Shadowtrance/Huiqin-Zhiyuan-ESP32-S31-CB-V1.1/11. Other materials/Information Website.txt

1、乐鑫官网：

https://www.espressif.com.cn/zh-hans

2、ESP产品选型指南：

https://products.espressif.com/#/product-selector?language=zh&names=

3、ESP-IDF 编程指南：

https://docs.espressif.com/projects/esp-idf/zh_CN/v6.1/esp32s31/index.html

4、VS Code 配置 ESP-IDF 插件：

https://docs.espressif.com/projects/vscode-esp-idf-extension/zh_CN/latest/index.html#

5、ESP-IDF组件下载地址：

https://dl.espressif.cn/dl/esp-idf/

6、VS Code下载地址：

https://code.visualstudio.com/Download
