Shadowtrance/Huiqin-Zhiyuan-ESP32-S31-CB-V1.1/3. Program source code/Source Code Update Log for the ESP32-S31 CB V1.1 Minimal System Board.pdf

东莞市慧勤智远科技有限公司

1

## ESP32-S31 CB V1.1 小系统板源码更新记录

日期 | 更新说明
2026-10-21 | 1、更新基础例程 (1) 增加例程数量。
