Shadowtrance/Huiqin-Zhiyuan-ESP32-S31-CB-V1.1/2. Schematic diagram/ESP32-S31 CB V1.1_SCH.pdf

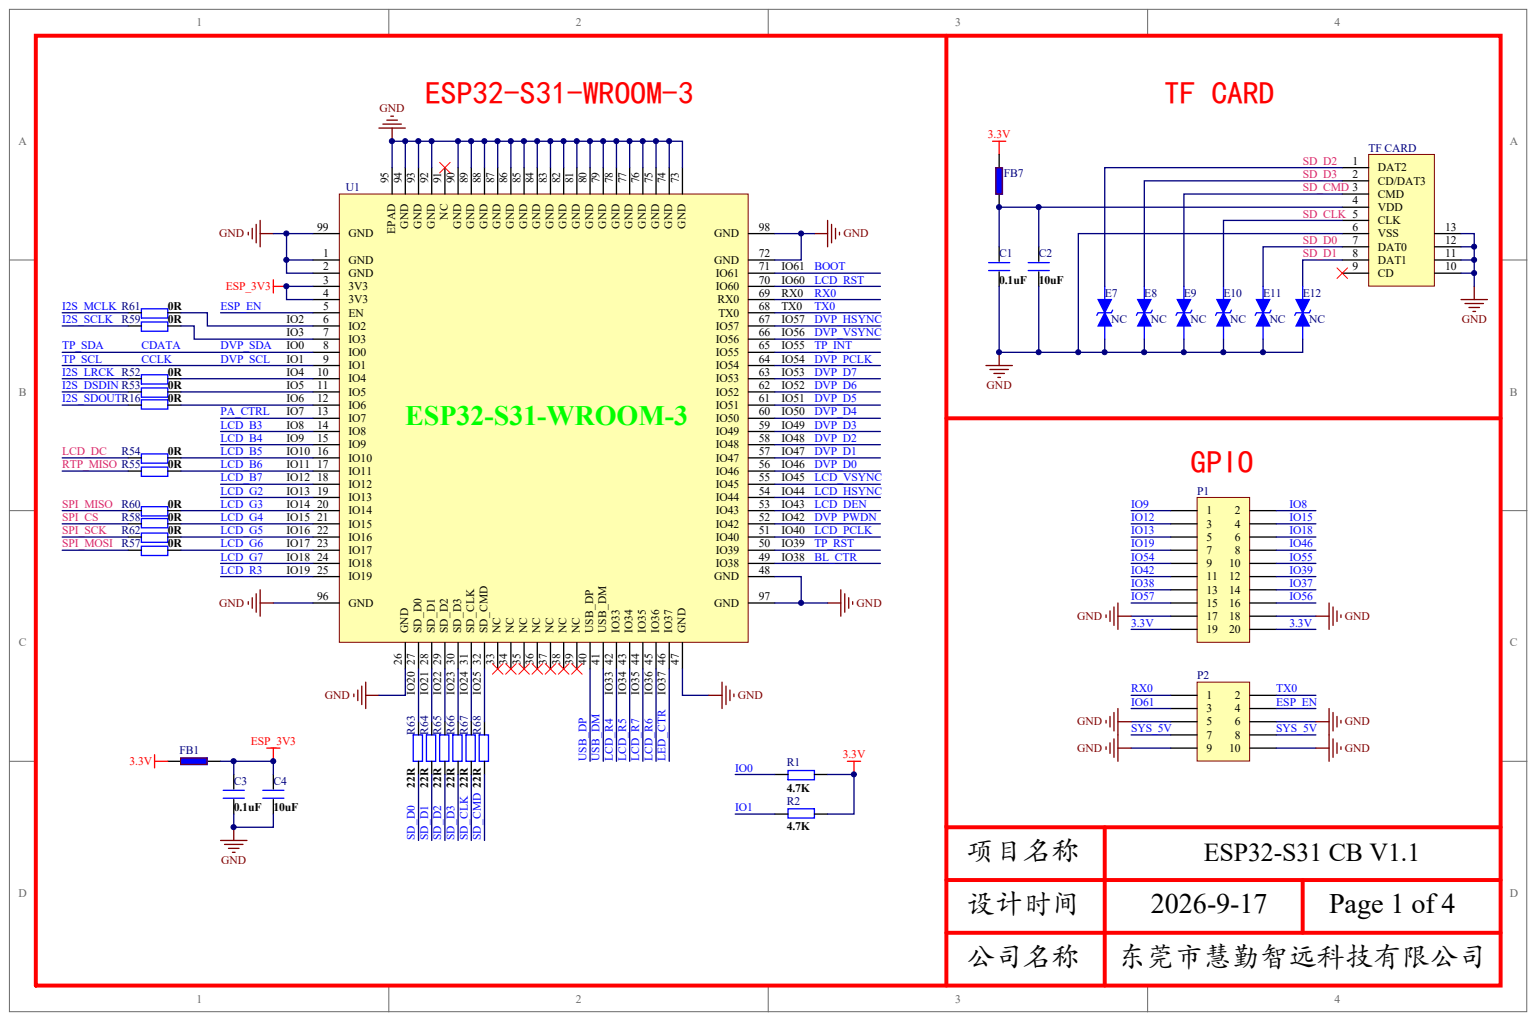
[picture p71: page 1]

GND 74 GND 75 GND 76 GND 77 GND 78 GND 79 GND 80 GND 81 GND 82 GND 83 GND 84 GND 85 GND 86 GND 87 GND 88 GND 89 GND 90 NC 91 GND 92 GND 93 GND 94 EPAD 95

D 3

SD_CLK | 5

项目名称 | ESP32-S31 CB V1.1

设计时间 | 2026-9-17 | Page 1 of 4
公司名称 | 东莞市慧勤智远科技有限公司

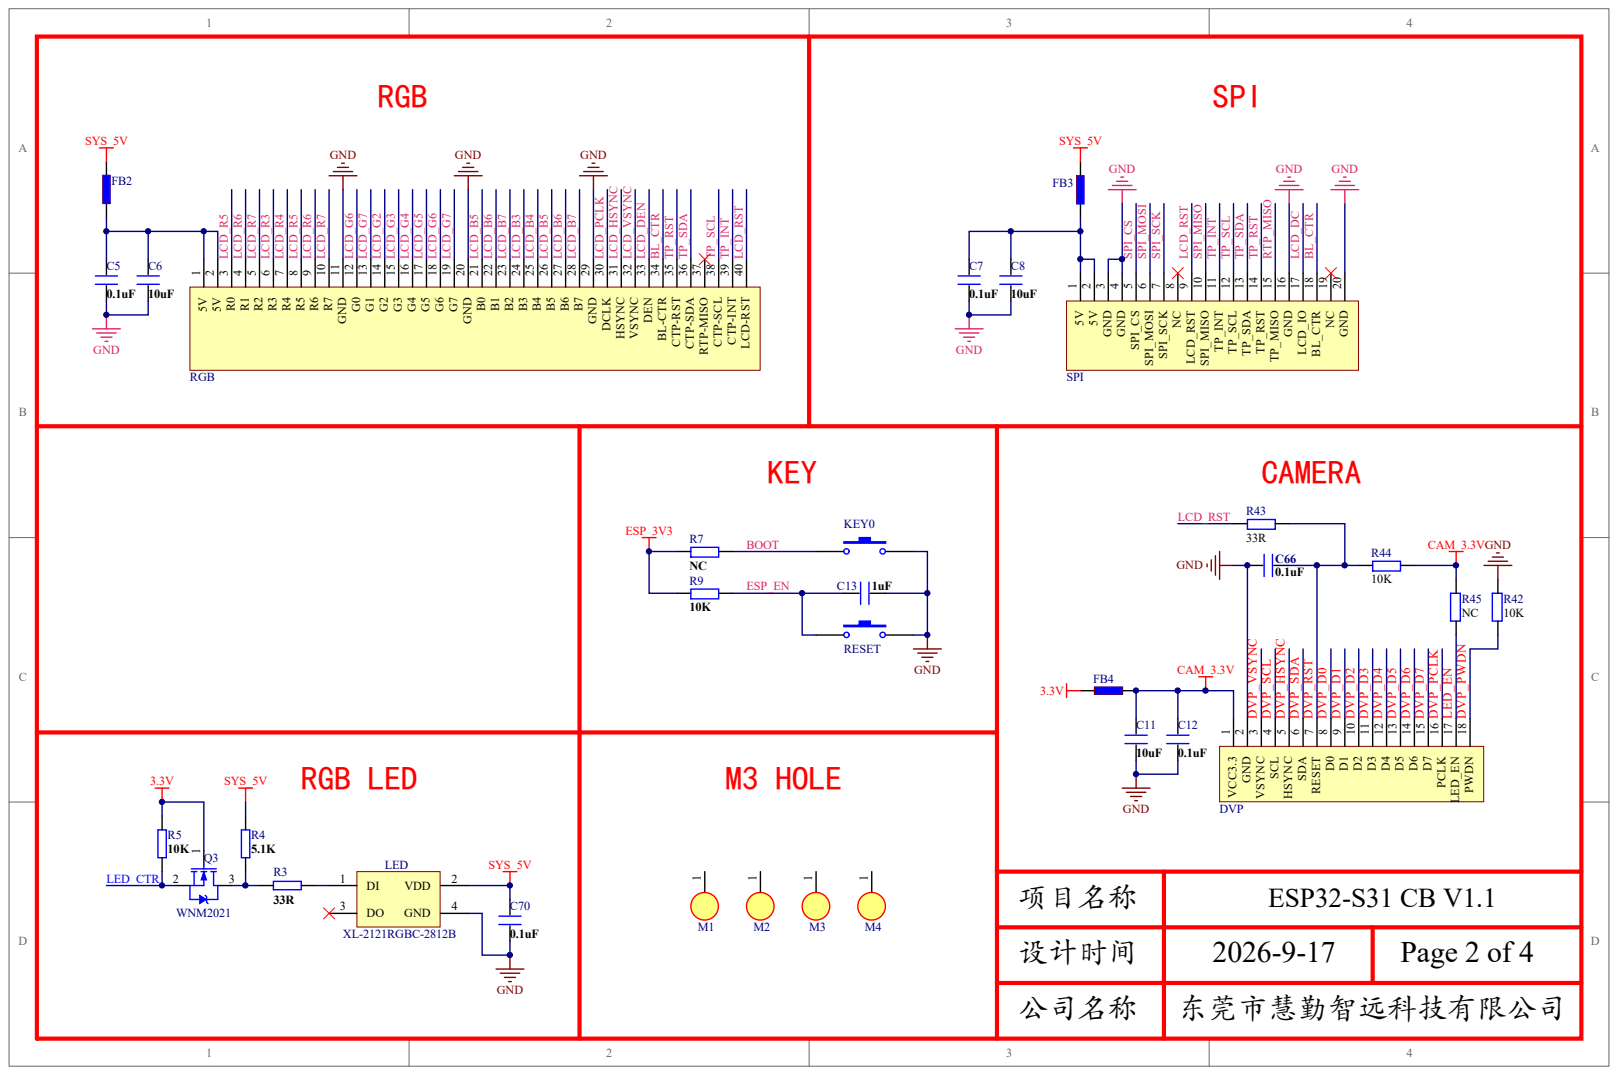
[picture p72: page 2]

设计时间 | 2026-9-17 | Page 2 of 4
公司名称 | 东莞市慧勤智远科技有限公司

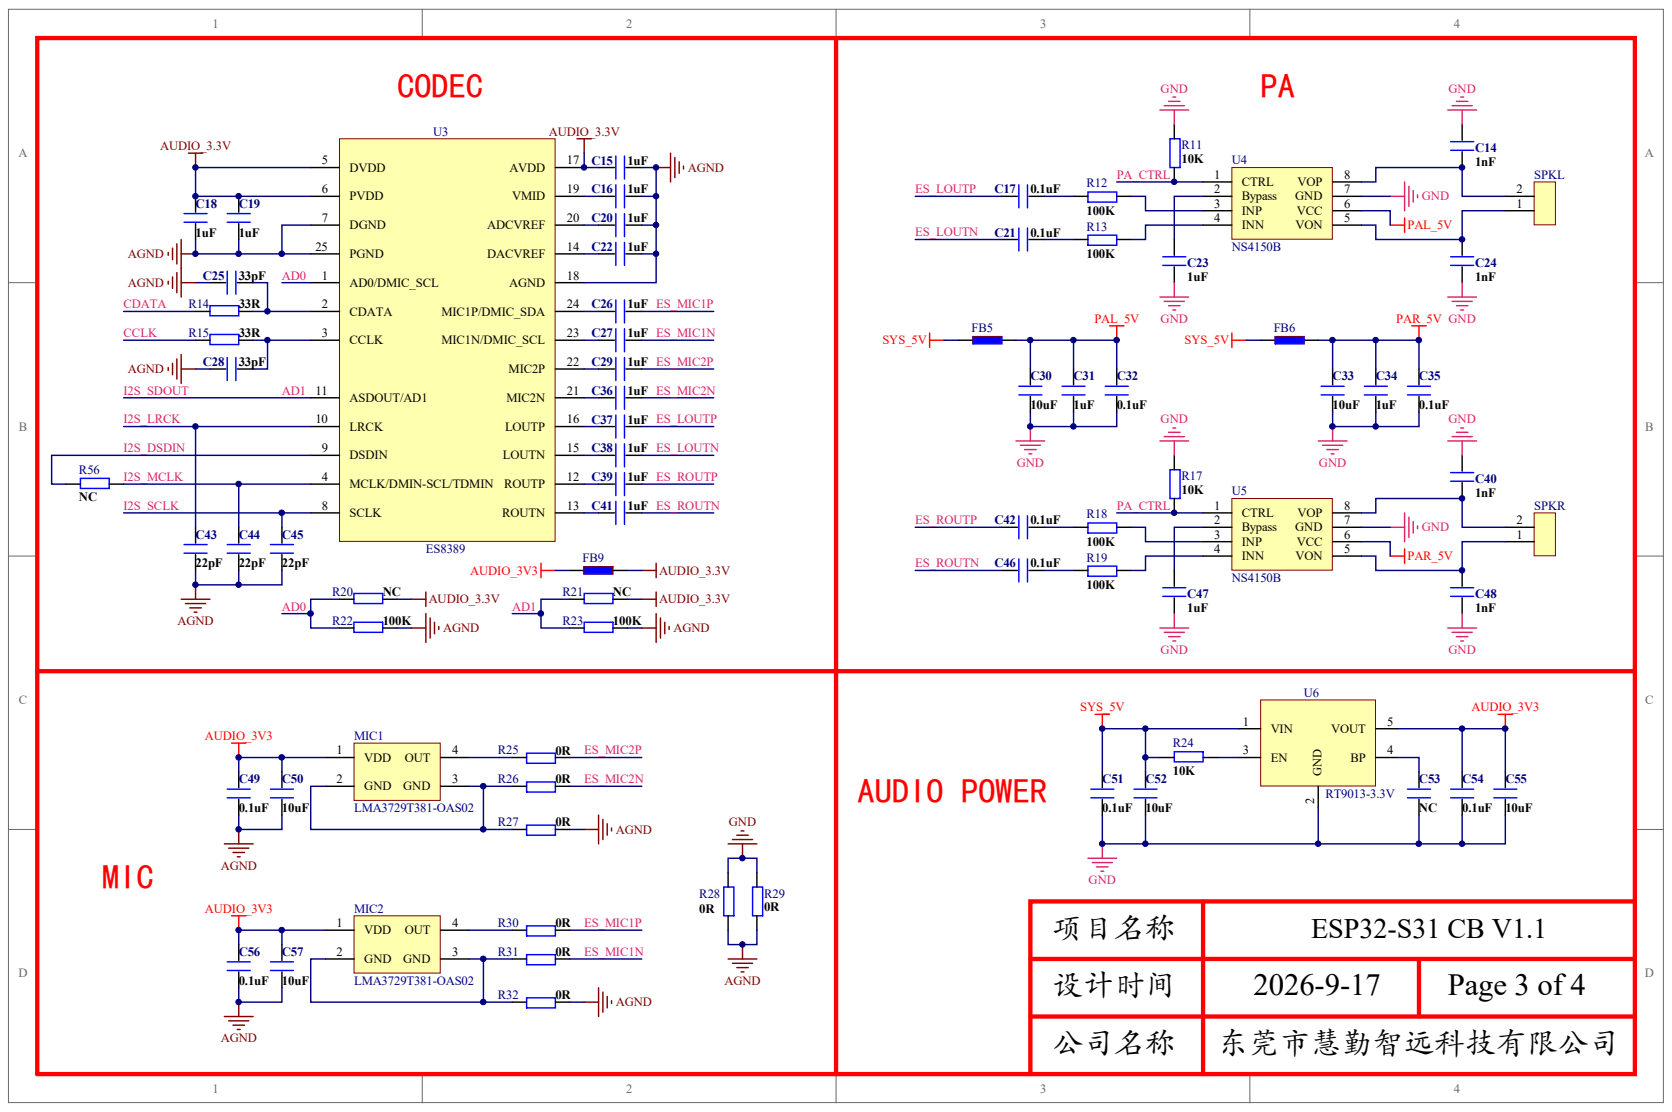
[picture p73: page 3]

R56 | MCLK/DMIN-SCL/TDMIN 4

C43 | SCLK 8

INP 3 | 1

项目名称 | ESP32-S31 CB V1.1

设计时间 | 2026-9-17 | Page 3 of 4
公司名称 | 东莞市慧勤智远科技有限公司

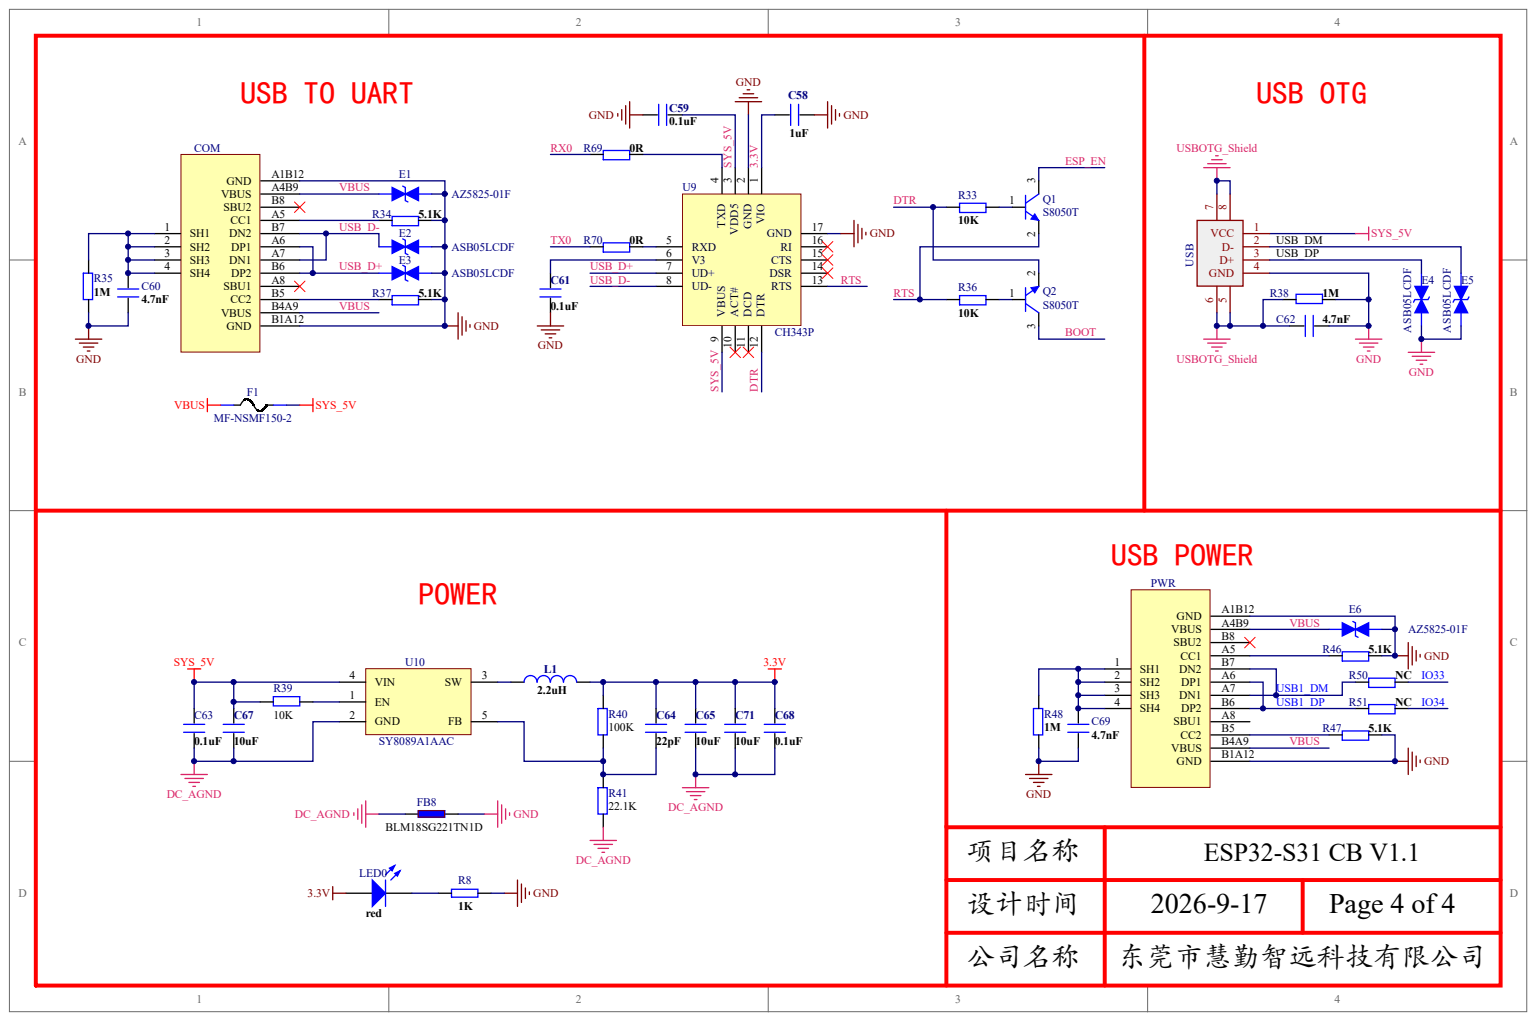
[picture p74: page 4]

项目名称 | ESP32-S31 CB V1.1

设计时间 | 2026-9-17 | Page 4 of 4
公司名称 | 东莞市慧勤智远科技有限公司
