Shadowtrance/Huiqin-Zhiyuan-ESP32-S31-CB-V1.1/10. Camera Module Information/OV2640 Camera Module Product Documentation/1，原理图/WKS-OV2640-V12.pdf

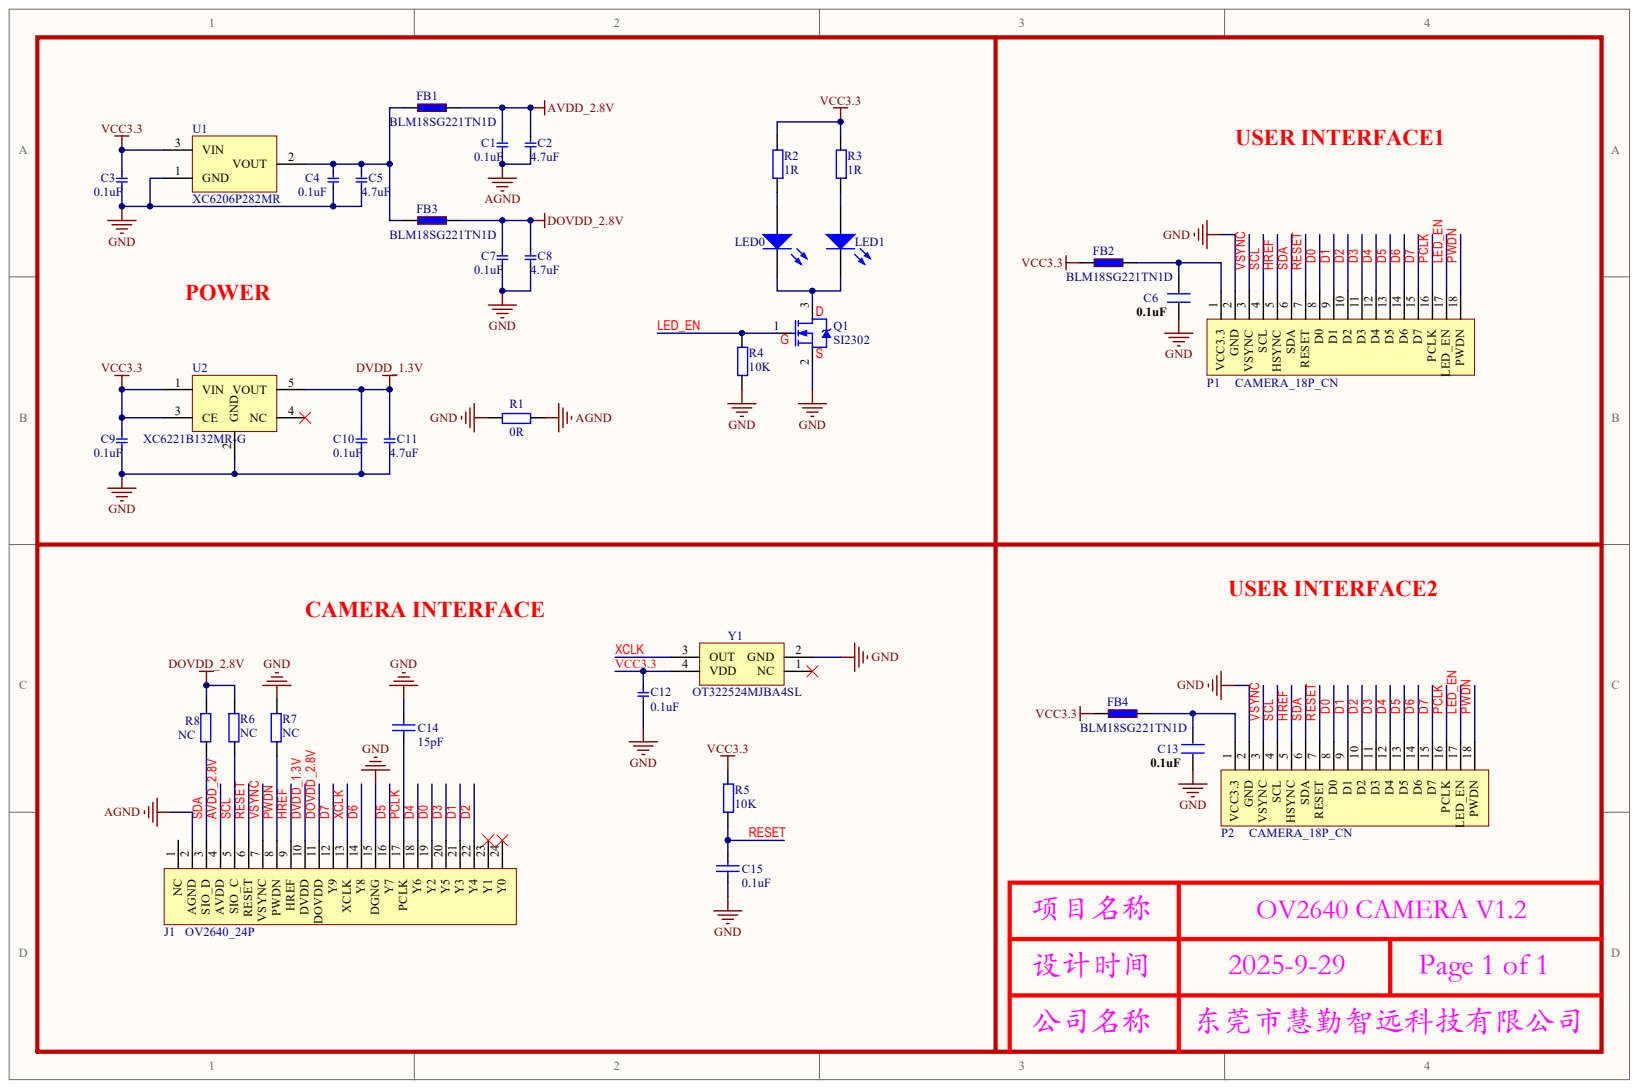
[picture p75: page 1]

项目名称 | OV2640 CAMERA V1.2
设计时间 | 2025-9-29 | Page 1 of 1
公司名称 | 东莞市慧勤智远科技有限公司
