Shadowtrance/Huiqin-Zhiyuan-ESP32-S31-CB-V1.1/2. Schematic diagram/ESP32-S31 CB V1.1 - Front Side Mount Diagram.pdf

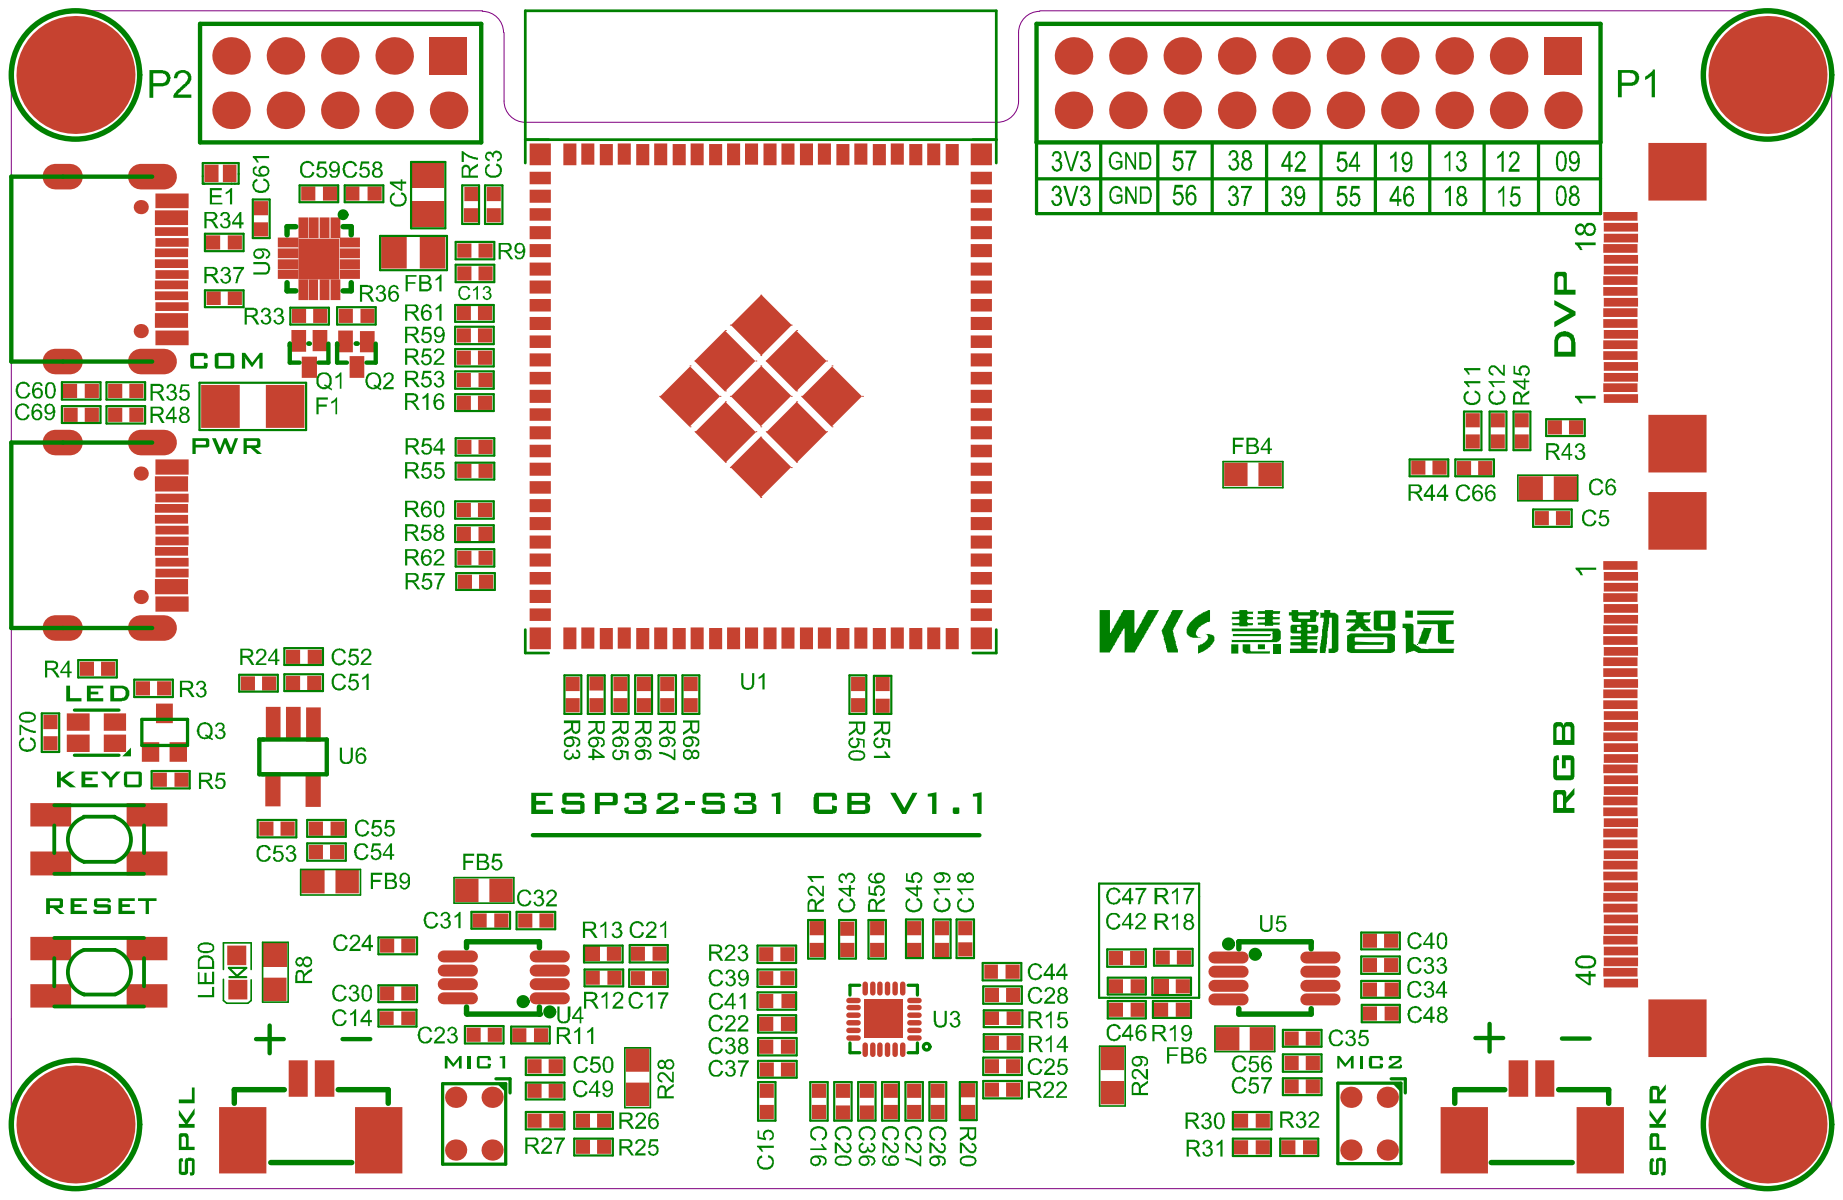
[picture p76: page 1]
