Shadowtrance/Huiqin-Zhiyuan-ESP32-S31-CB-V1.1/2. Schematic diagram/ESP32-S31 CB V1.1 - Rear Part Number Diagram.pdf

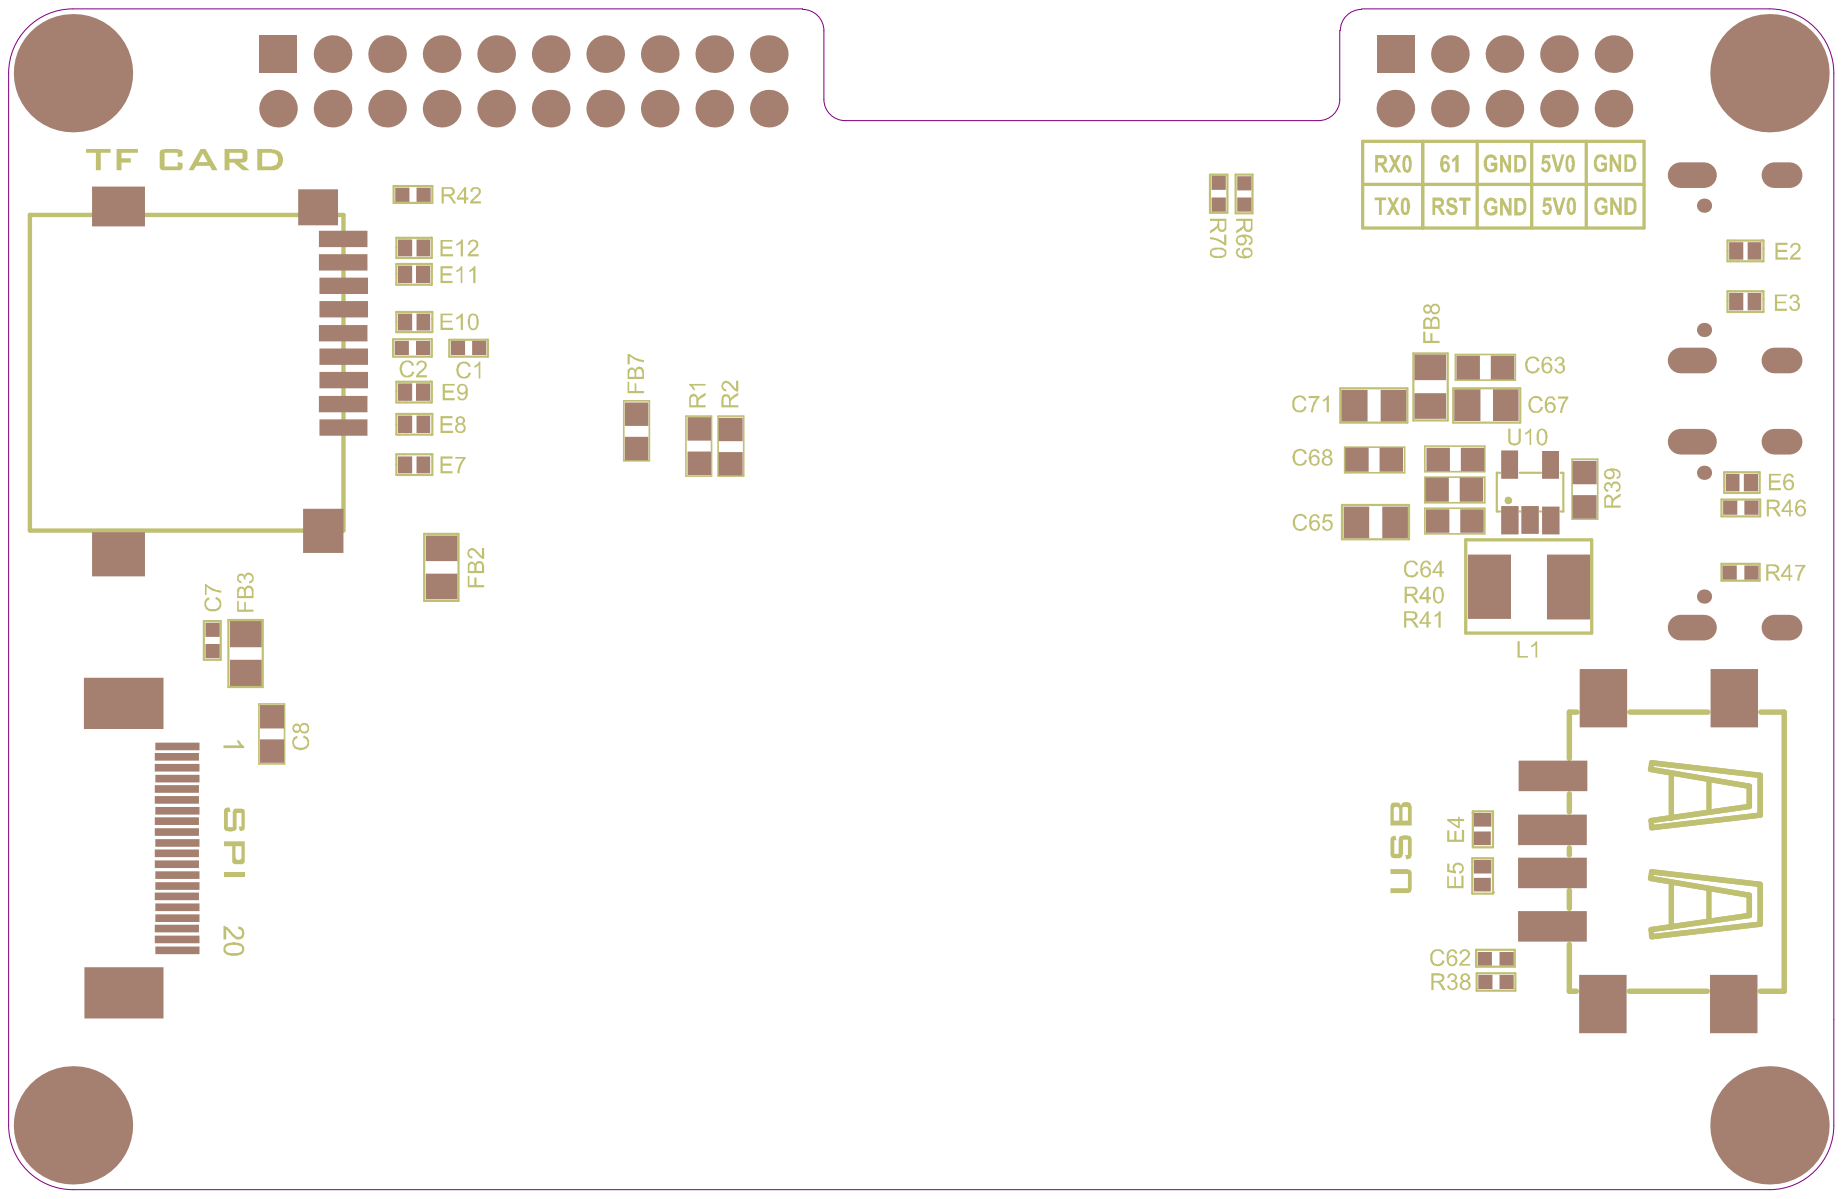
[picture p77: page 1]
