Shadowtrance/Huiqin-Zhiyuan-ESP32-S31-CB-V1.1/6. Development board structure diagram/ESP32-S31 CB V1.1_Structural Diagram.PDF

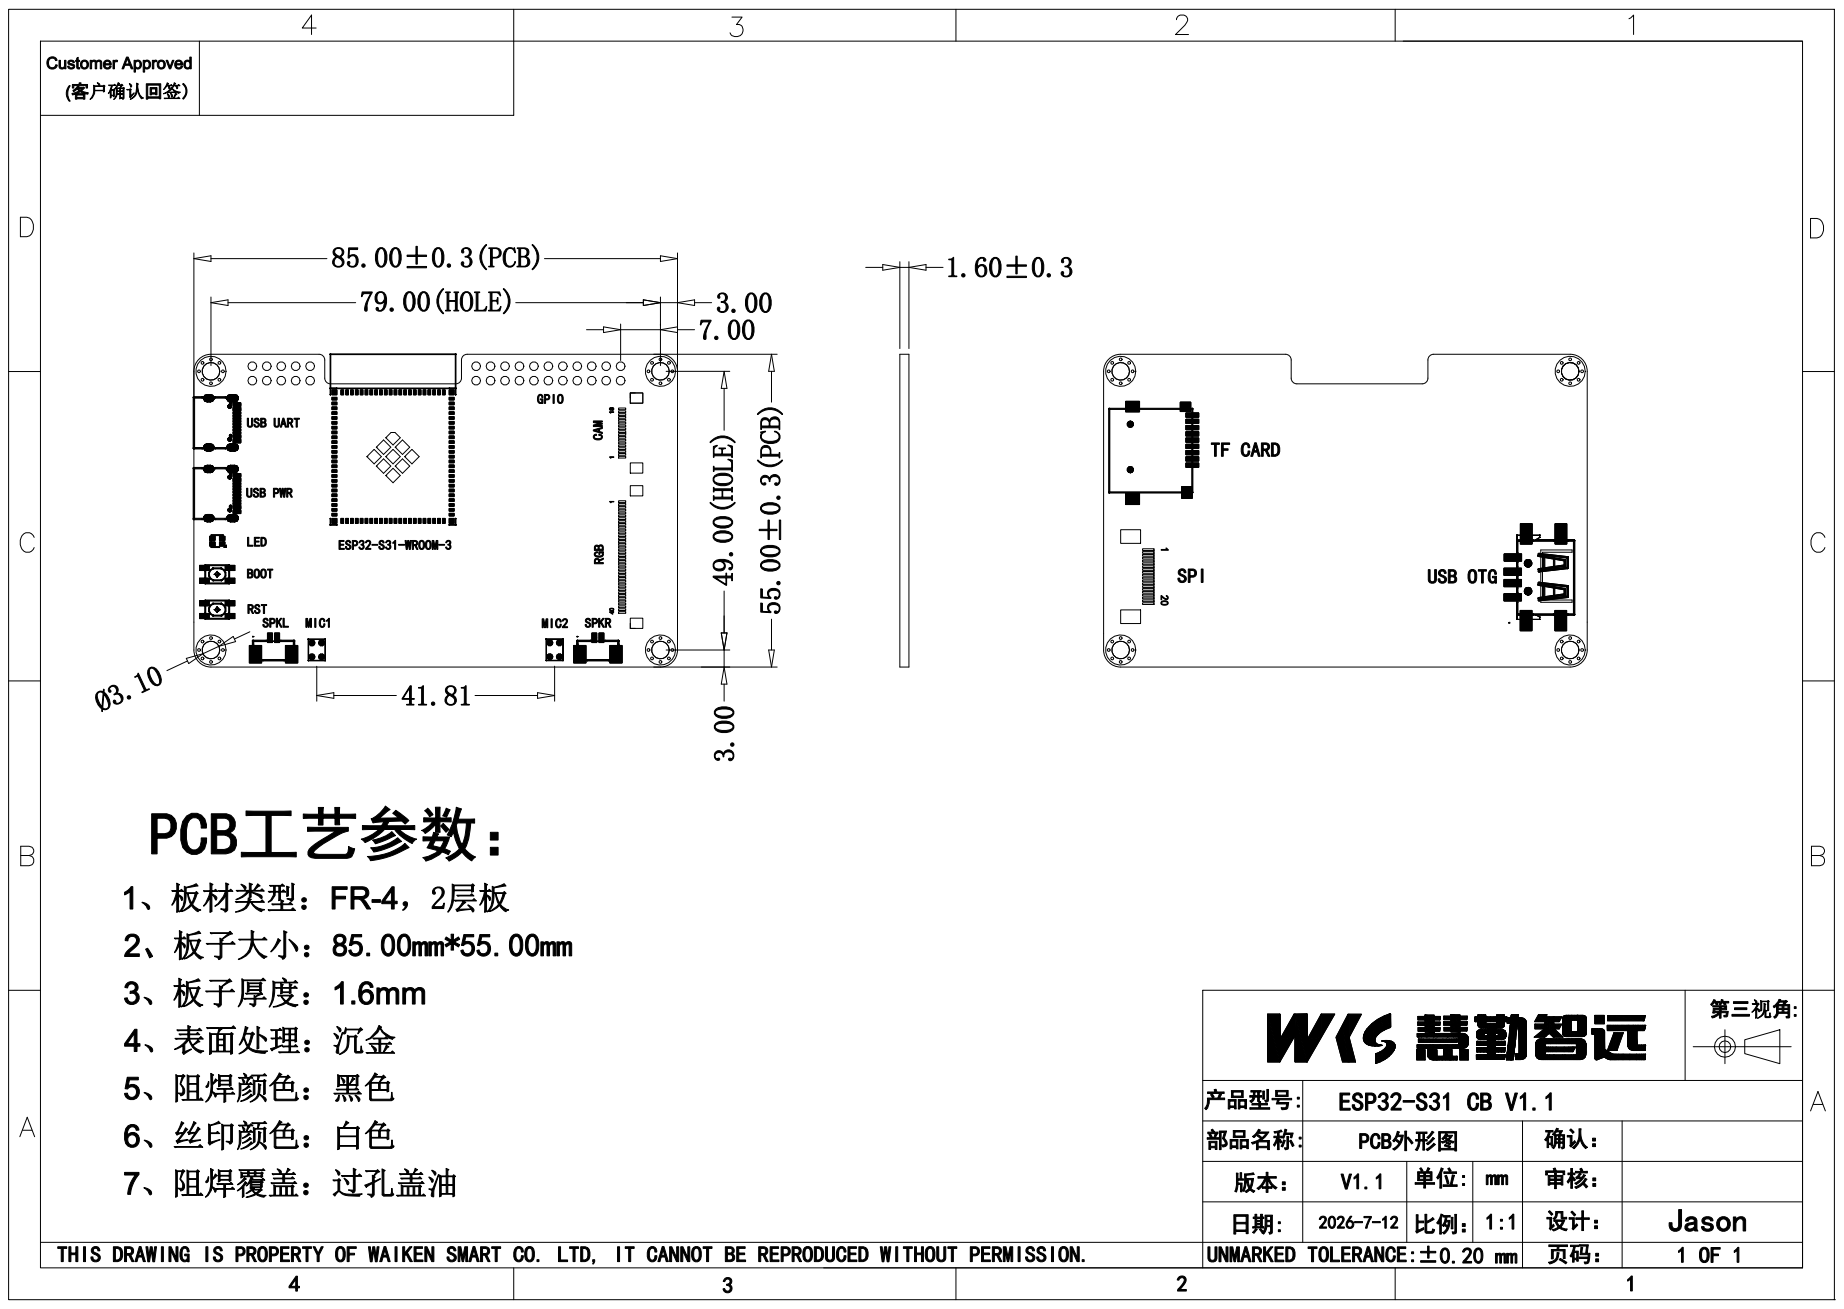
[picture p78: page 1]
