Shadowtrance/Huiqin-Zhiyuan-ESP32-S31-CB-V1.1/10. Camera Module Information/OV2640 Camera Module Product Documentation/2，结构图/WKS-OV2640 V1.2外形图.PDF

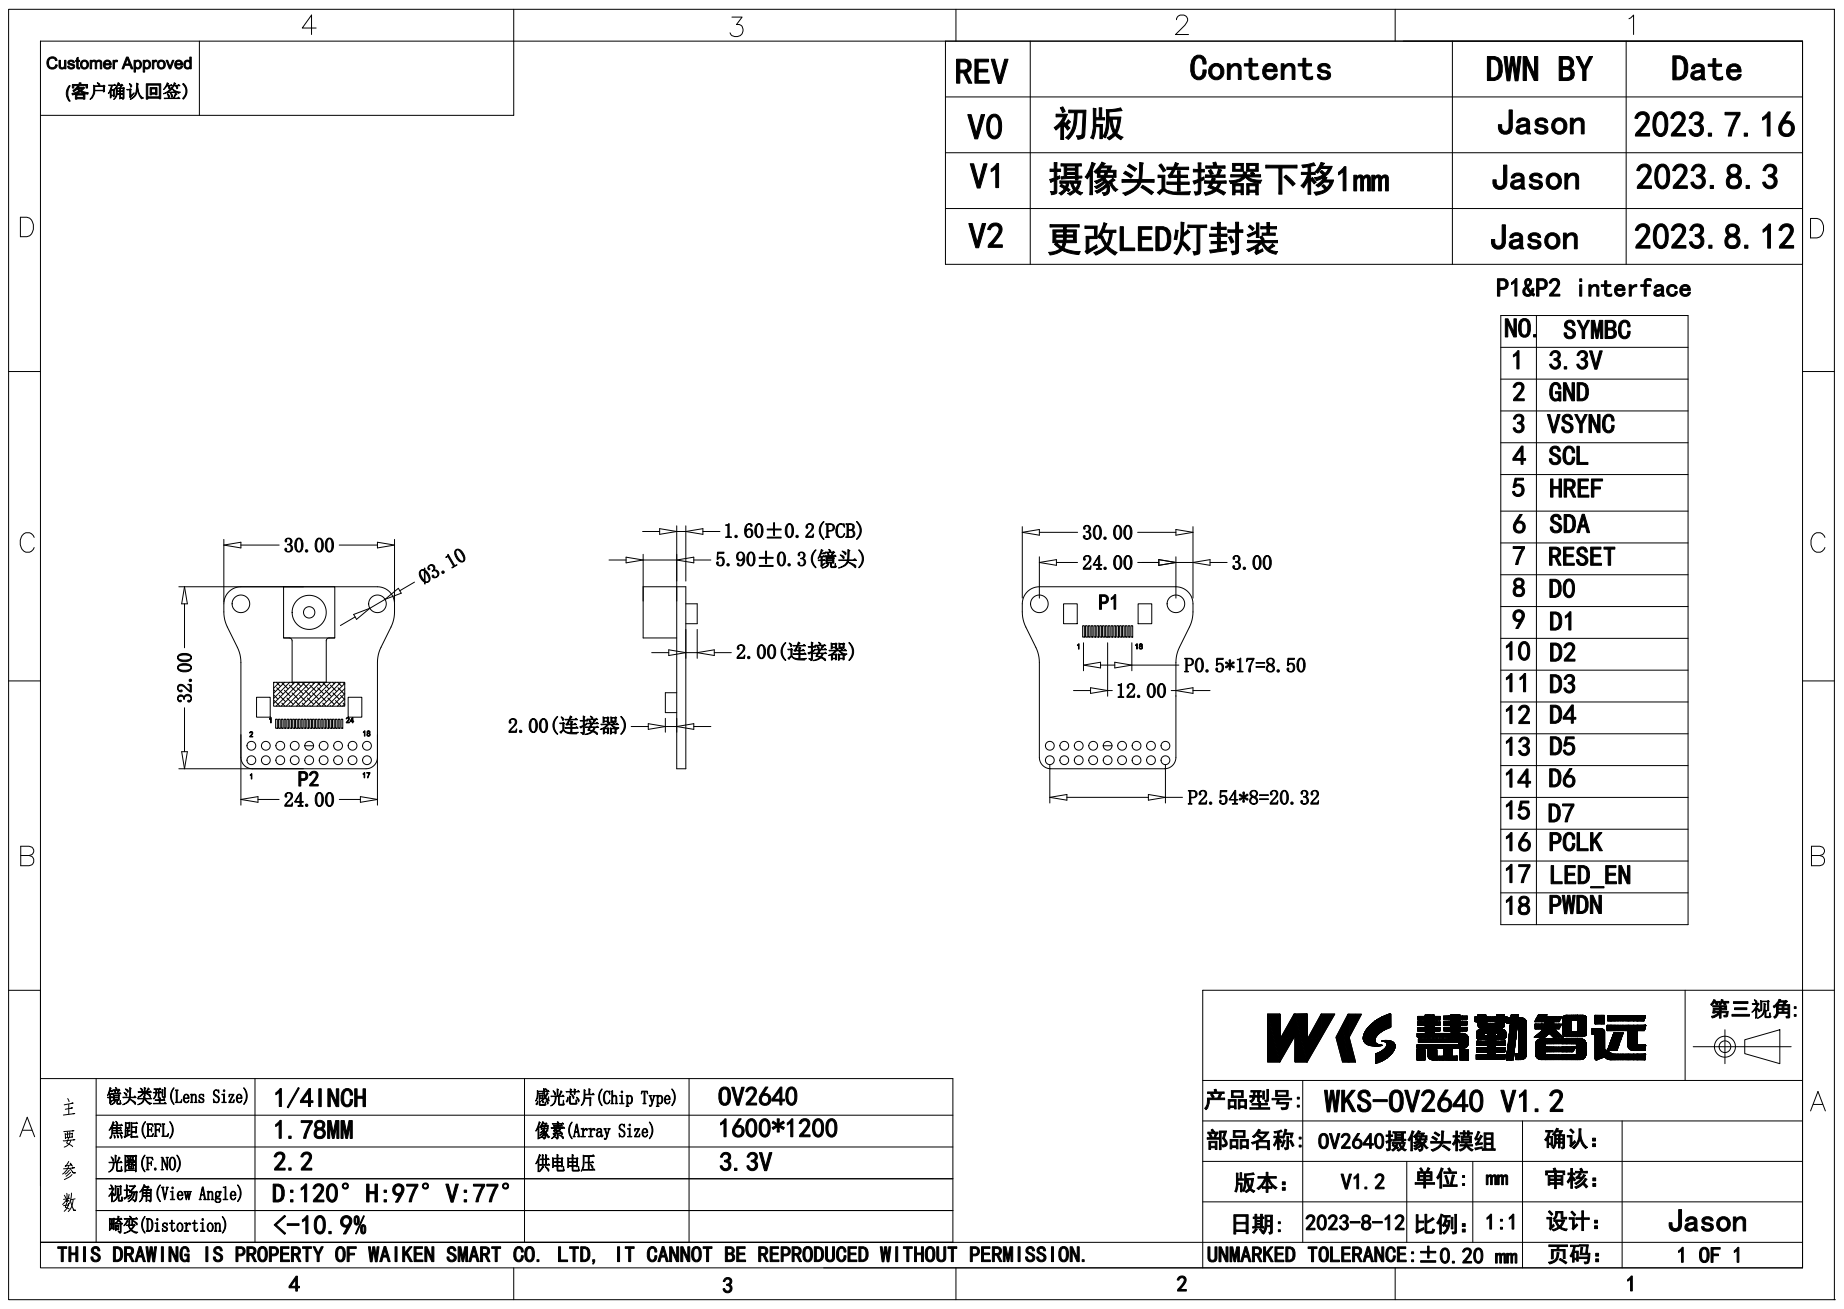
[picture p79: page 1]
