Shadowtrance/Huiqin-Zhiyuan-ESP32-S31-CB-V1.1/10. Camera Module Information/OV5640 Camera Module Product Documentation/1.原理图/PCB-OV5640V0.pdf

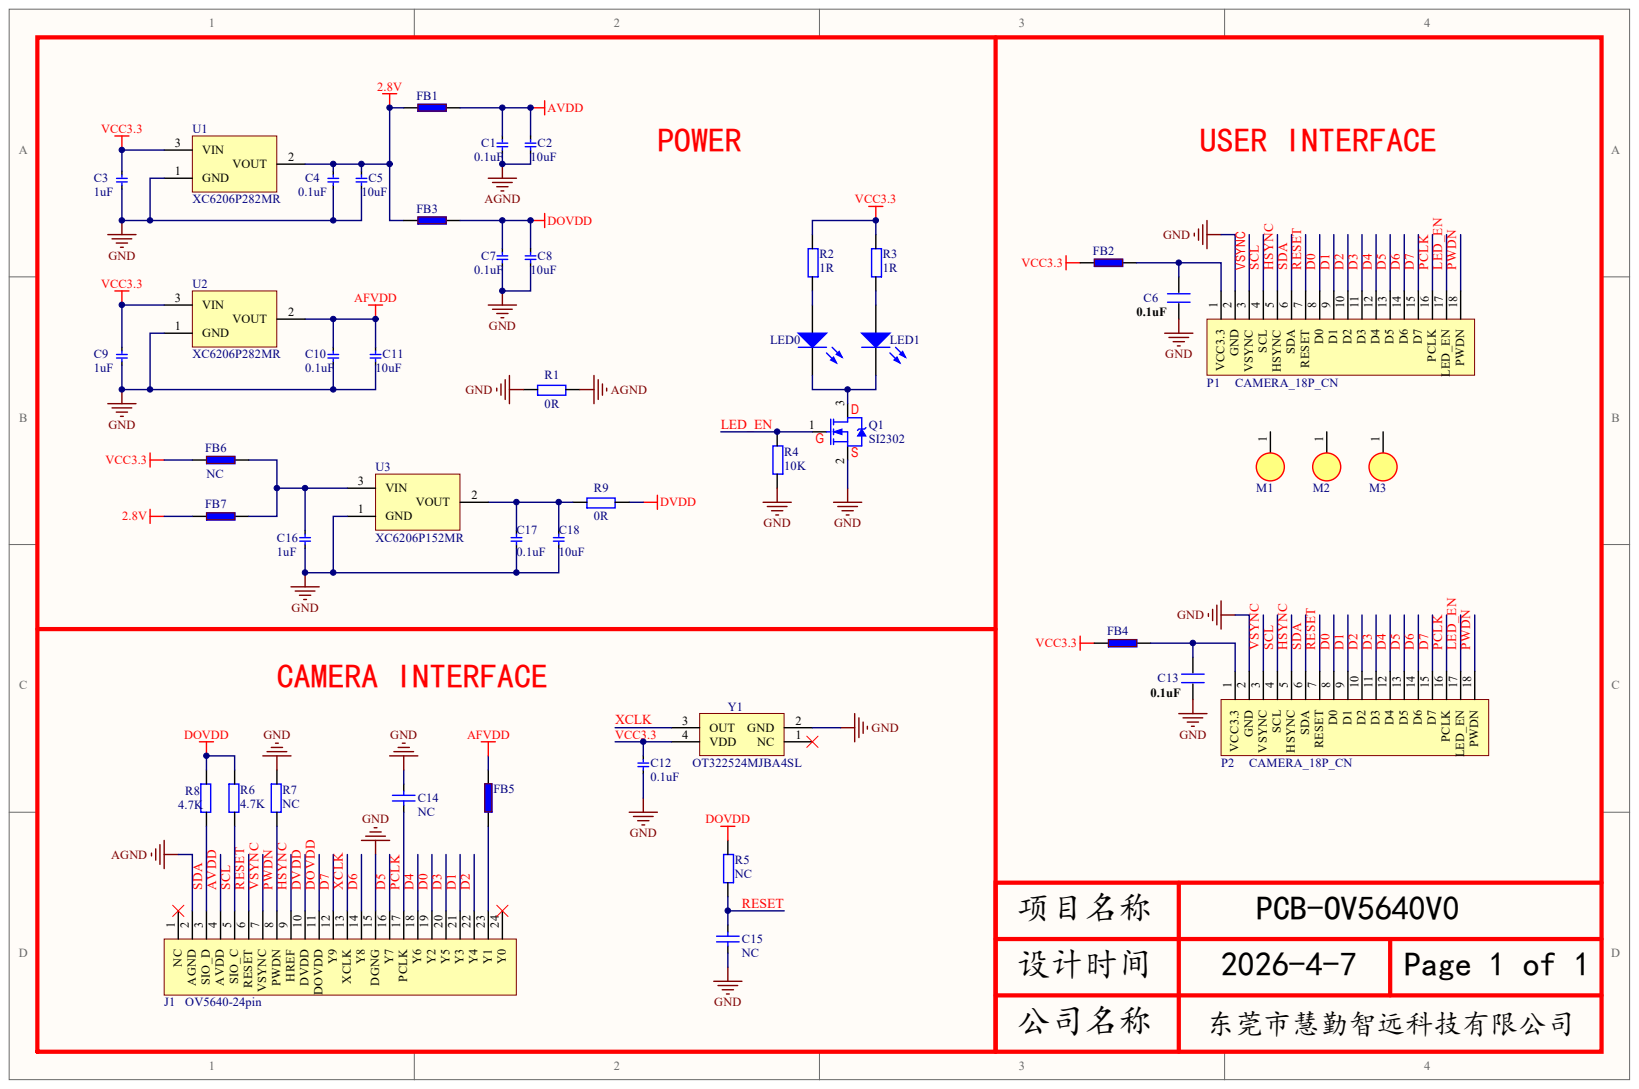
[picture p80: page 1]
