Shadowtrance/Huiqin-Zhiyuan-ESP32-S31-CB-V1.1/10. Camera Module Information/OV5640 Camera Module Product Documentation/2.结构图/PCB-OV5640V0.PDF

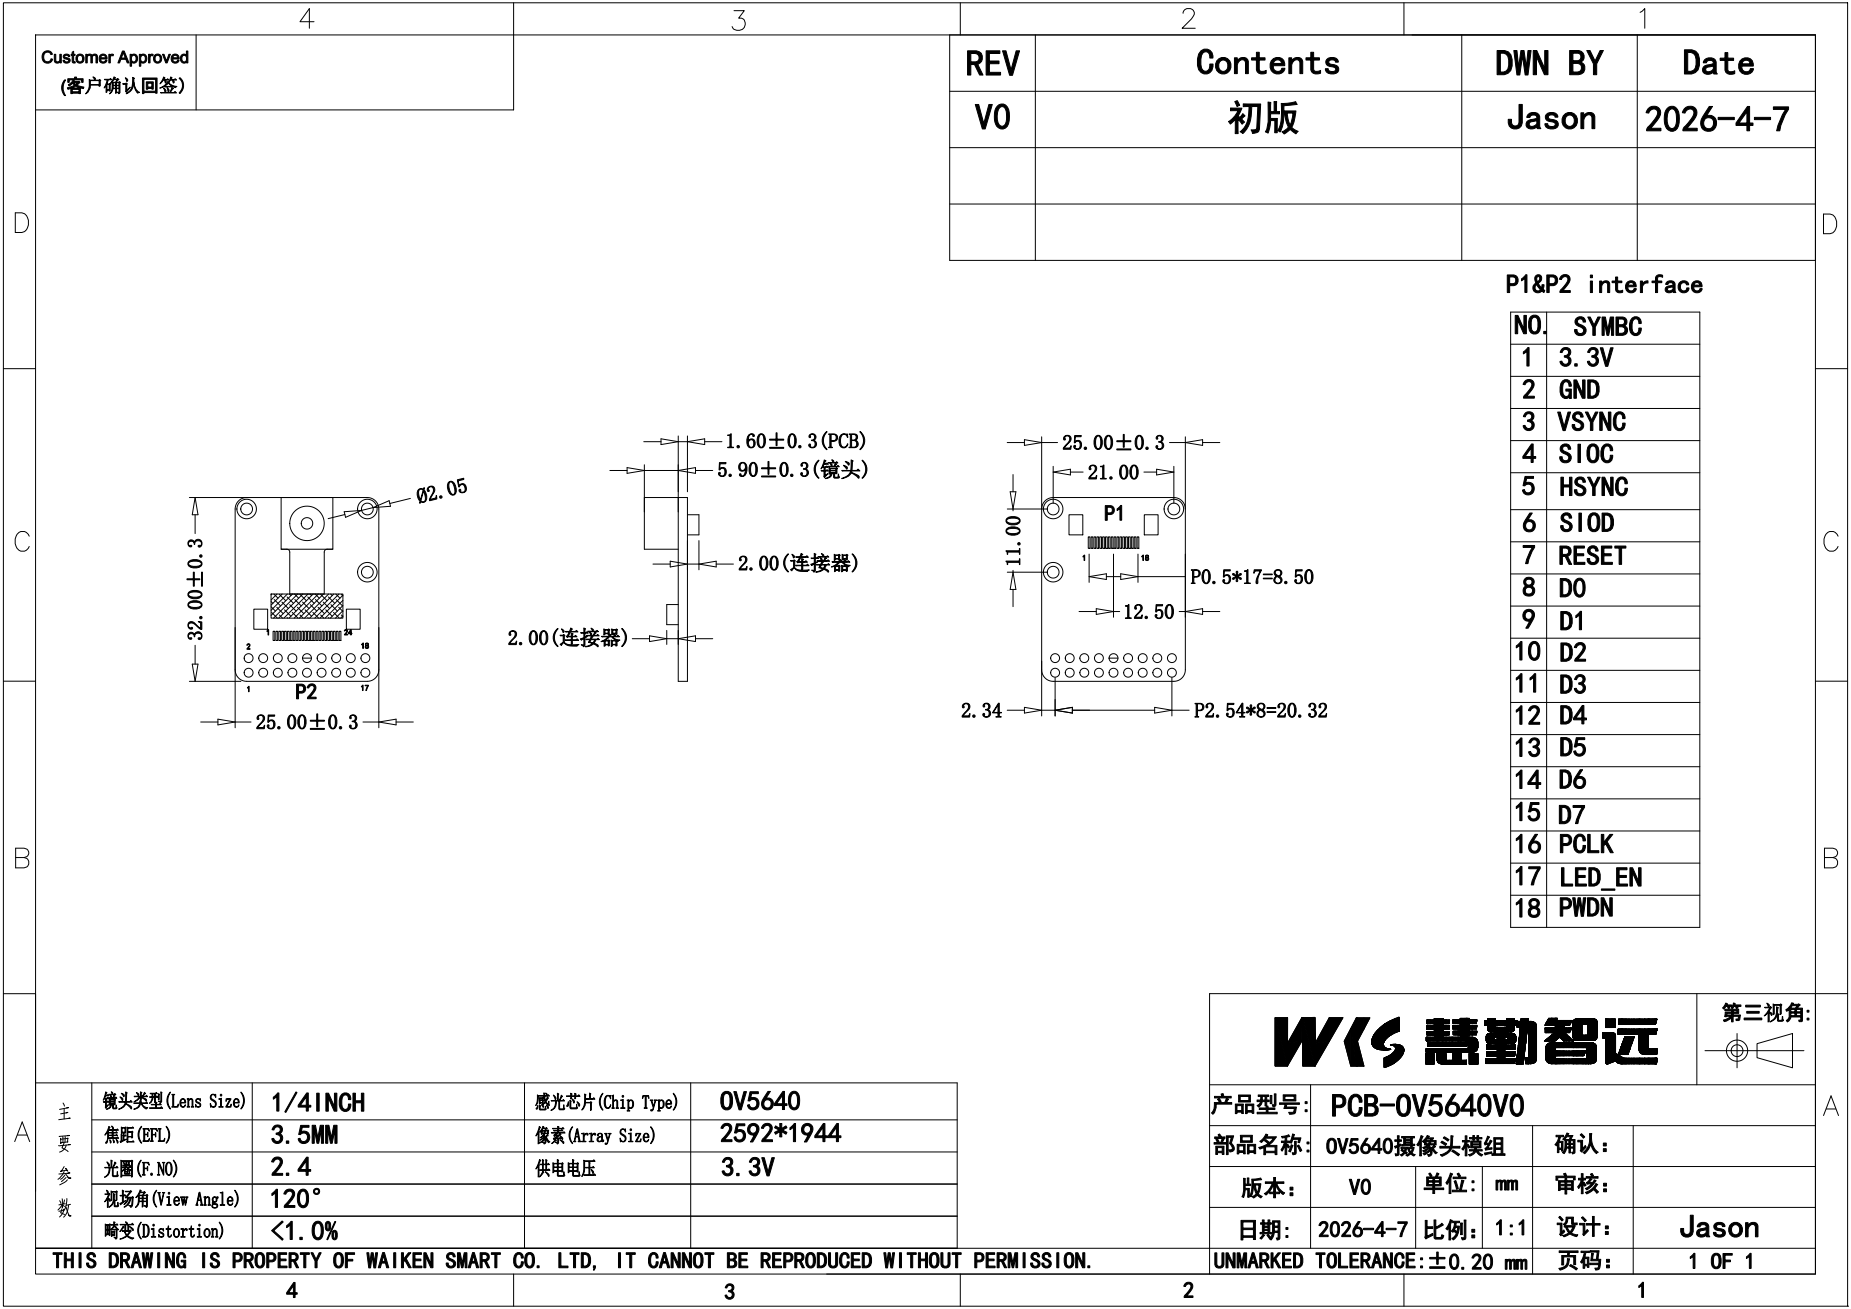
[picture p81: page 1]
