Shadowtrance/Huiqin-Zhiyuan-ESP32-S31-CB-V1.1/(list of files, drawings)

Other design files:
5. Component package library/AD09 Footprint Library/ESP32-S31 CB V1.1.PcbLib
5. Component package library/AD09 Footprint Library/ESP32-S31 CB V1.1.SCHLIB
